Yubin-dev0/thesis-edgeai-adaptive-kalman-embedded/tests/06_kf_integration_verification/csv_extracted/phase6_step6_csv.csv

seq | timestamp_ms | enc_L | enc_R | pos_L_mm | pos_R_mm | tof_dist_mm | tof_status | tof_signal_mcps | tof_ambient_mcps | kf_estimate | kf_covariance | residual | residual_var | residual_mean | kalman_gain | innovation_cov | scenario_id
0 | 7 | 0 | 0 | 0.000 | 0.000 | 124 | 0 | 23.016 | 0.156 | 124.000 | 400.000 | 0.000 | 0.000 | 0.000 | 0.000000 | 0.000 | 0
1 | 25 | 0 | 0 | 0.000 | 0.000 | 123 | 0 | 22.211 | 0.156 | 123.499 | 200.250 | -1.000 | 0.000 | 0.000 | 0.500624 | 801.000 | 0
2 | 45 | 0 | 0 | 0.000 | 0.000 | 123 | 0 | 22.102 | 0.188 | 123.332 | 133.888 | -0.499 | 0.000 | 0.000 | 0.334719 | 601.250 | 0
3 | 65 | 0 | 0 | 0.000 | 0.000 | 122 | 0 | 22.086 | 0.164 | 122.996 | 100.872 | -1.332 | 0.000 | 0.000 | 0.252179 | 534.888 | 0
4 | 85 | 0 | 0 | 0.000 | 0.000 | 122 | 0 | 22.078 | 0.180 | 122.794 | 81.193 | -0.996 | 0.000 | 0.000 | 0.202984 | 501.872 | 0
5 | 107 | 0 | 0 | 0.000 | 0.000 | 121 | 0 | 22.180 | 0.156 | 122.705 | 58.982 | -2.000 | 0.000 | 0.000 | 0.147454 | 469.183 | 0
6 | 127 | 0 | 0 | 0.000 | 0.000 | 126 | 0 | 22.133 | 0.188 | 123.134 | 52.160 | 3.295 | 0.000 | 0.000 | 0.130400 | 459.982 | 0
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
