Yubin-dev0/thesis-edgeai-adaptive-kalman-embedded/tests/00_power_verification/logs/phase0_wiring_overview.jpg

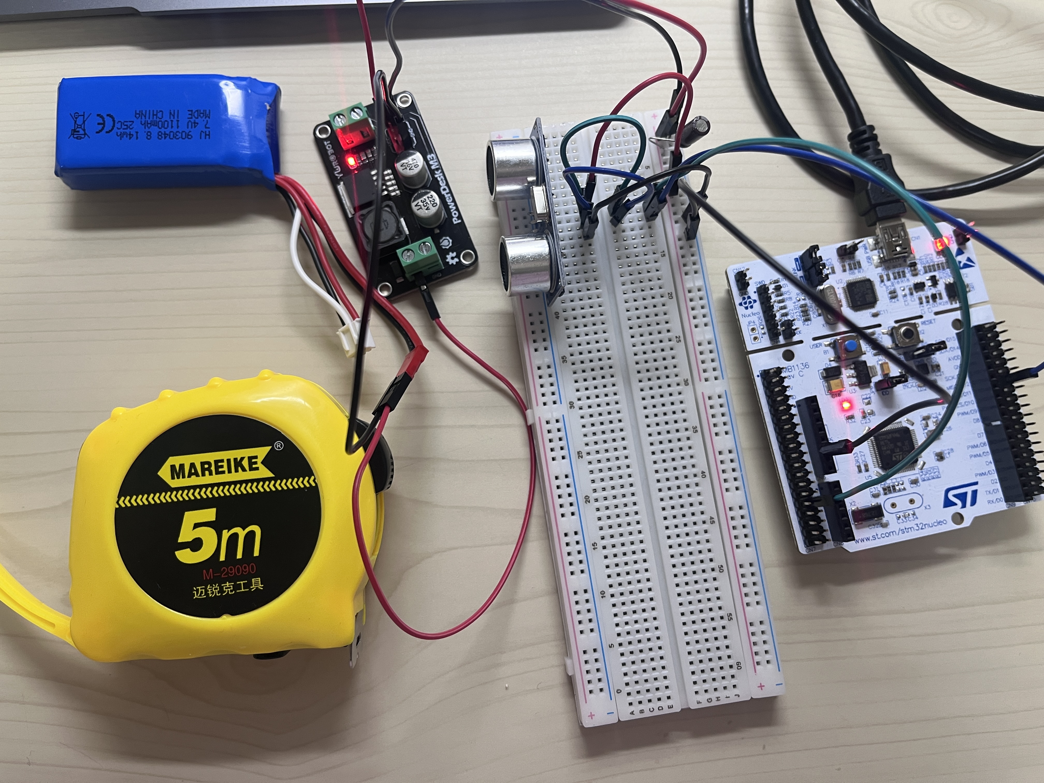
tests/00_power_verification/logs/phase0_wiring_overview.jpg
