Yubin-dev0/thesis-edgeai-adaptive-kalman-embedded/tests/04A_motor_standalone_verification/logs/motor_wiring_overview.jpg

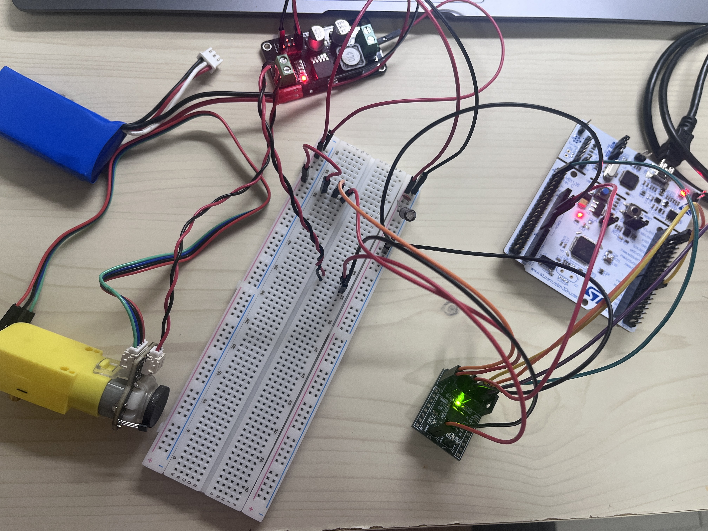
tests/04A_motor_standalone_verification/logs/motor_wiring_overview.jpg
