Yubin-dev0/thesis-edgeai-adaptive-kalman-embedded/tests/07_manual_integration_verification/wiring_overview.jpg

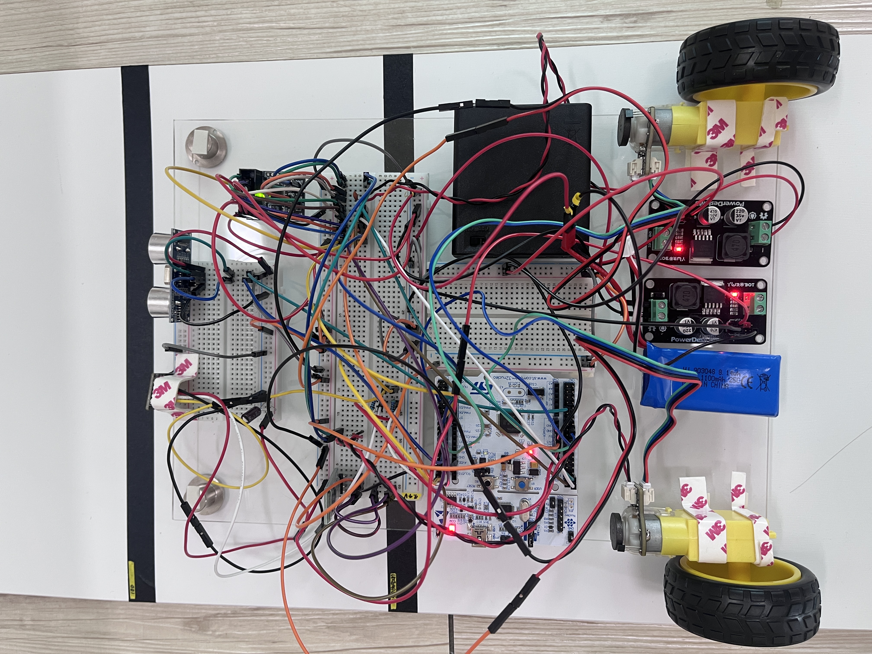
tests/07_manual_integration_verification/wiring_overview.jpg
