Yubin-dev0/thesis-edgeai-adaptive-kalman-embedded/tests/03_hcsr04_verification/TEST_RESULT.md

# Phase 3: HC-SR04 Ultrasonic Sensor Verification

## Objective
Validate HC-SR04 distance measurement using TIM3 Input Capture interrupts (no polling, no main-loop blocking).

## Hardware Setup
- **MCU**: STM32 NUCLEO-F446RE (HSE 8MHz BYPASS via ST-LINK MCO → PLL → 180MHz SYSCLK)
- **Sensor**: HC-SR04 ultrasonic ranging module
- **Power**: NUCLEO 5V (USB-powered)
- **Decoupling**: 100nF ceramic capacitor across HC-SR04 VCC–GND — *not present on the final build (verified 2026-09-22); the +5 V rail feeding HC-SR04 and VL53L0X carries one 100 µF 16 V electrolytic instead*

### Wiring
| HC-SR04 | NUCLEO Pin | Function |
|---|---|---|
| VCC | 5V | Power |
| GND | GND | Ground |
| Trig | PA1 | GPIO Output |
| Echo | PA6 | TIM3_CH1 (Input Capture, 5V tolerant) |

## Firmware Configuration
- **TIM3**: Prescaler = 89, Period = 65535 → 1 µs resolution, 65.535 ms range
- **Input Capture**: Both edges (rising → falling), Direct mode, no filter
- **Trigger**: 10 µs pulse generated with DWT cycle counter delay
- **Trigger period**: 50 ms (20 Hz)
- **Distance formula**: `d_mm = pulse_us × 0.1715` (speed of sound ÷ 2)
- **printf retarget**: USART2 @ 115200 baud (ST-LINK VCP)

## Test Results

### 3-1: Trigger + Echo Capture
| Item | Result | Pass/Fail |
|---|---|---|
| `echo_ready` flag set after each trigger | Yes, 985 consecutive captures | ✅ Pass |
| Both rising/falling edges captured | Verified via pulse width values | ✅ Pass |

### 3-2: Fixed Distance Accuracy
Reference distances using A4 paper (297 mm long edge).

| Target | Measured Mean | Error | Std Dev (σ) | Samples | Pass/Fail |
|---|---|---|---|---|---|
| 297 mm (1 sheet) | 291.3 mm | -5.7 mm | ±5.6 mm | 214 | ✅ Pass |
| 594 mm (2 sheets) | 575.3 mm | -18.7 mm | ±3.5 mm | 156 | ⚠️ Marginal |
| 891 mm (3 sheets) | 871.4 mm | -19.6 mm | ±4.9 mm | 164 | ⚠️ Marginal |

**Notes on 594 mm / 891 mm results:**
The systematic offset (~-19 mm) is consistent across both multi-sheet measurements but absent in the single-sheet test. This strongly suggests **mechanical alignment error from overlapping A4 sheets** during reference distance setup, not a sensor or firmware issue. Sensor jitter remained excellent (σ < 5 mm) at all distances, well within HC-SR04 datasheet spec (±3 mm + 1%). Re-measurement with a calibrated ruler is planned once available.

### 3-3: 20 Hz Trigger Period
| Item | Result | Pass/Fail |
|---|---|---|
| Measurement count over 50 s | 985 samples | ✅ Pass (~19.7 Hz) |
| `echo_ready` flag period | ~50 ms | ✅ Pass |

### 3-4: Non-Blocking Main Loop
| Item | Result | Pass/Fail |
|---|---|---|
| `loop_max` (DWT-measured) | 5130 µs | ✅ Pass* |
| Main loop blocked during echo wait | 0 µs (interrupt-driven) | ✅ Pass |
| `while`-loop polling on Echo pin | None (verified by code review) | ✅ Pass |

*Note: The 5.1 ms `loop_max` is dominated by `HAL_UART_Transmit` blocking during printf (~50 chars × 87 µs/char @ 115200 baud ≈ 4.3 ms). Echo wait itself contributes 0 µs since capture is fully interrupt-driven. Will be replaced with DMA-based UART output in a later phase.

## Key Learnings
1. **HSE BYPASS mode** is required on NUCLEO boards (not Crystal/Resonator) since the ST-LINK MCU supplies an 8 MHz clock signal directly.
2. **100nF decoupling cap** placed at the sensor pins eliminated VCC noise during ultrasonic burst transmission. *(Phase 3 bench observation; the cap is not on the final build — see Hardware Setup.)*
3. **TIM3 Input Capture with Both Edges polarity** allows capturing rising and falling edges on a single channel by toggling polarity in the ISR — no need for two channels.
4. **DWT cycle counter** provides sub-microsecond delay precision and zero-overhead loop timing measurement, essential for verifying non-blocking behavior.
5. **Systematic measurement offset** vs random jitter — when errors are consistent in magnitude and direction across samples, the root cause is almost always physical setup, not sensor or firmware.

## Files
- `firmware/Core/Src/main.c` — HC-SR04 driver in USER CODE sections
- `logs/putty4.log` — Final test session capture

## Status
✅ **Phase 3 Complete** — HC-SR04 functional with interrupt-driven capture. Ready to proceed to Phase 4.
