Yubin-dev0/thesis-edgeai-adaptive-kalman-embedded/experiments/E1_baseline/logs_final/E1_run01.csv

seq | timestamp_ms | tof_distance_mm | tof_signal_rate | tof_range_status | us_distance_mm | encoder_distance_mm | encoder_speed_mms | sensor_disagree | tof_meas_rate | gt_distance_mm | scenario_id | fixed_estimate_mm | fixed_residual | fixed_residual_var | fixed_residual_mean | fixed_kalman_gain | fixed_innovation_cov | cm_estimate_mm | cm_residual | cm_residual_var | cm_residual_mean | cm_kalman_gain | cm_innovation_cov | cm_R | tinyml_estimate_mm | tinyml_R | tinyml_infer_us
0 | 7 | 514 | 3.812 | 0 | 0.000 | 0.000 | 0.000 | 514.000 | 1.000 | 0.000 | 1 | 514.000 | 0.000 | 0.000 | 0.000 | 0.000000 | 0.000 | 514.000 | 0.000 | 0.000 | 0.000 | 0.000000 | 0.000 | 24.000 | 514.000 | 24.000 | 0
1 | 25 | 518 | 3.695 | 0 | 492.548 | 0.000 | 0.000 | 25.452 | 1.000 | 0.000 | 1 | 516.041 | 4.000 | 0.000 | 0.000 | 0.510204 | 49.000 | 516.041 | 4.000 | 0.000 | 0.000 | 0.510204 | 49.000 | 24.000 | 517.483 | 3.714 | 35
2 | 45 | 512 | 3.656 | 0 | 492.548 | 0.000 | 0.000 | 19.452 | 1.000 | 0.000 | 1 | 514.604 | -4.041 | 0.000 | 0.000 | 0.355616 | 37.245 | 514.604 | -4.041 | 0.000 | 0.000 | 0.355616 | 37.245 | 24.000 | 514.562 | 3.714 | 35
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
