Yubin-dev0/thesis-edgeai-adaptive-kalman-embedded/experiments/E1_baseline/logs/E1_run01.csv

seq | timestamp_ms | tof_distance_mm | tof_signal_rate | tof_range_status | us_distance_mm | encoder_distance_mm | encoder_speed_mms | sensor_disagree | tof_meas_rate | gt_distance_mm | scenario_id | fixed_estimate_mm | fixed_residual | fixed_residual_var | fixed_residual_mean | fixed_kalman_gain | fixed_innovation_cov | cm_estimate_mm | cm_residual | cm_residual_var | cm_residual_mean | cm_kalman_gain | cm_innovation_cov | cm_R
0 | 7 | 522 | 3.641 | 0 | 0.000 | 0.000 | 0.000 | 522.000 | 0.000 | 0.000 | 1 | 522.000 | 0.000 | 0.000 | 0.000 | 0.000000 | 0.000 | 522.000 | 0.000 | 0.000 | 0.000 | 0.000000 | 0.000 | 24.000
1 | 25 | 527 | 3.555 | 0 | 488.432 | 0.000 | 0.000 | 38.568 | 5.000 | 0.000 | 1 | 524.551 | 5.000 | 0.000 | 0.000 | 0.510204 | 49.000 | 524.551 | 5.000 | 0.000 | 0.000 | 0.510204 | 49.000 | 24.000
2 | 45 | 510 | 3.625 | 0 | 488.432 | 0.000 | 0.000 | 21.568 | -17.000 | 0.000 | 1 | 519.376 | -14.551 | 0.000 | 0.000 | 0.355616 | 37.245 | 519.376 | -14.551 | 0.000 | 0.000 | 0.355616 | 37.245 | 24.000
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
