Yubin-dev0/thesis-edgeai-adaptive-kalman-embedded/experiments/E1_baseline/logs/E1_run02.csv

seq | timestamp_ms | tof_distance_mm | tof_signal_rate | tof_range_status | us_distance_mm | encoder_distance_mm | encoder_speed_mms | sensor_disagree | tof_meas_rate | gt_distance_mm | scenario_id | fixed_estimate_mm | fixed_residual | fixed_residual_var | fixed_residual_mean | fixed_kalman_gain | fixed_innovation_cov | cm_estimate_mm | cm_residual | cm_residual_var | cm_residual_mean | cm_kalman_gain | cm_innovation_cov | cm_R
0 | 7 | 510 | 3.523 | 0 | 0.000 | 0.000 | 0.000 | 510.000 | 0.000 | 0.000 | 1 | 510.000 | 0.000 | 0.000 | 0.000 | 0.000000 | 0.000 | 510.000 | 0.000 | 0.000 | 0.000 | 0.000000 | 0.000 | 24.000
2 | 45 | 512 | 3.570 | 0 | 488.432 | 0.000 | 0.000 | 23.568 | -3.000 | 0.000 | 1 | 512.355 | -0.551 | 0.000 | 0.000 | 0.355616 | 37.245 | 512.355 | -0.551 | 0.000 | 0.000 | 0.355616 | 37.245 | 24.000
3 | 65 | 513 | 3.625 | 0 | 488.432 | 0.000 | 0.000 | 24.568 | 1.000 | 0.000 | 1 | 512.538 | 0.645 | 0.000 | 0.000 | 0.284325 | 33.535 | 512.538 | 0.645 | 0.000 | 0.000 | 0.284325 | 33.535 | 24.000
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
