Yubin-dev0/thesis-edgeai-adaptive-kalman-embedded/experiments/E1_baseline/logs/E1_run03.csv

seq | timestamp_ms | tof_distance_mm | tof_signal_rate | tof_range_status | us_distance_mm | encoder_distance_mm | encoder_speed_mms | sensor_disagree | tof_meas_rate | gt_distance_mm | scenario_id | fixed_estimate_mm | fixed_residual | fixed_residual_var | fixed_residual_mean | fixed_kalman_gain | fixed_innovation_cov | cm_estimate_mm | cm_residual | cm_residual_var | cm_residual_mean | cm_kalman_gain | cm_innovation_cov | cm_R
0 | 7 | 520 | 3.594 | 0 | 0.000 | 0.000 | 0.000 | 520.000 | 0.000 | 0.000 | 1 | 520.000 | 0.000 | 0.000 | 0.000 | 0.000000 | 0.000 | 520.000 | 0.000 | 0.000 | 0.000 | 0.000000 | 0.000 | 24.000
1 | 27 | 508 | 3.508 | 0 | 486.374 | 0.000 | 0.000 | 21.626 | -12.000 | 0.000 | 1 | 513.878 | -12.000 | 0.000 | 0.000 | 0.510204 | 49.000 | 513.878 | -12.000 | 0.000 | 0.000 | 0.510204 | 49.000 | 24.000
2 | 45 | 503 | 3.516 | 0 | 486.374 | 0.000 | 0.000 | 16.626 | -5.000 | 0.000 | 1 | 510.009 | -10.878 | 0.000 | 0.000 | 0.355616 | 37.245 | 510.009 | -10.878 | 0.000 | 0.000 | 0.355616 | 37.245 | 24.000
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
