Yubin-dev0/thesis-edgeai-adaptive-kalman-embedded/experiments/E1_baseline/logs/E1_run04.csv

seq | timestamp_ms | tof_distance_mm | tof_signal_rate | tof_range_status | us_distance_mm | encoder_distance_mm | encoder_speed_mms | sensor_disagree | tof_meas_rate | gt_distance_mm | scenario_id | fixed_estimate_mm | fixed_residual | fixed_residual_var | fixed_residual_mean | fixed_kalman_gain | fixed_innovation_cov | cm_estimate_mm | cm_residual | cm_residual_var | cm_residual_mean | cm_kalman_gain | cm_innovation_cov | cm_R
0 | 7 | 504 | 3.438 | 0 | 0.000 | 0.000 | 0.000 | 504.000 | 0.000 | 0.000 | 1 | 504.000 | 0.000 | 0.000 | 0.000 | 0.000000 | 0.000 | 504.000 | 0.000 | 0.000 | 0.000 | 0.000000 | 0.000 | 24.000
1 | 27 | 508 | 3.562 | 0 | 492.719 | 0.000 | 0.000 | 15.281 | 4.000 | 0.000 | 1 | 506.041 | 4.000 | 0.000 | 0.000 | 0.510204 | 49.000 | 506.041 | 4.000 | 0.000 | 0.000 | 0.510204 | 49.000 | 24.000
2 | 47 | 516 | 3.594 | 0 | 492.719 | 0.000 | 0.000 | 23.281 | 8.000 | 0.000 | 1 | 509.582 | 9.959 | 0.000 | 0.000 | 0.355616 | 37.245 | 509.582 | 9.959 | 0.000 | 0.000 | 0.355616 | 37.245 | 24.000
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
