Yubin-dev0/thesis-edgeai-adaptive-kalman-embedded/experiments/E1_baseline/logs/E1_run05.csv

seq | timestamp_ms | tof_distance_mm | tof_signal_rate | tof_range_status | us_distance_mm | encoder_distance_mm | encoder_speed_mms | sensor_disagree | tof_meas_rate | gt_distance_mm | scenario_id | fixed_estimate_mm | fixed_residual | fixed_residual_var | fixed_residual_mean | fixed_kalman_gain | fixed_innovation_cov | cm_estimate_mm | cm_residual | cm_residual_var | cm_residual_mean | cm_kalman_gain | cm_innovation_cov | cm_R
0 | 7 | 518 | 3.516 | 0 | 0.000 | 0.000 | 0.000 | 518.000 | 0.000 | 0.000 | 1 | 518.000 | 0.000 | 0.000 | 0.000 | 0.000000 | 0.000 | 518.000 | 0.000 | 0.000 | 0.000 | 0.000000 | 0.000 | 24.000
1 | 25 | 512 | 3.500 | 0 | 486.717 | 0.000 | 0.000 | 25.283 | -6.000 | 0.000 | 1 | 514.939 | -6.000 | 0.000 | 0.000 | 0.510204 | 49.000 | 514.939 | -6.000 | 0.000 | 0.000 | 0.510204 | 49.000 | 24.000
2 | 45 | 508 | 3.594 | 0 | 486.717 | 0.000 | 0.000 | 21.283 | -4.000 | 0.000 | 1 | 512.471 | -6.939 | 0.000 | 0.000 | 0.355616 | 37.245 | 512.471 | -6.939 | 0.000 | 0.000 | 0.355616 | 37.245 | 24.000
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
