Yubin-dev0/thesis-edgeai-adaptive-kalman-embedded/firmware/Core/Src/network.c

/**
  ******************************************************************************
  * @file    network.c
  * @author  AST Embedded Analytics Research Platform
  * @date    2026-05-20T19:15:52+0900
  * @brief   AI Tool Automatic Code Generator for Embedded NN computing
  ******************************************************************************
  * @attention
  *
  * Copyright (c) 2026 STMicroelectronics.
  * All rights reserved.
  *
  * This software is licensed under terms that can be found in the LICENSE file
  * in the root directory of this software component.
  * If no LICENSE file comes with this software, it is provided AS-IS.
  ******************************************************************************
  */

#include "ai_lite_inspect.h"
#include "ai_platform_interface.h"
#include "layers.h"
#include "core_convert.h"
#include "network.h"
#include "network_details.h"
#include "network_data.h"
#include "stai_events.h"

#include "ai_lite_inspect.h"

#include "lite_operators.h"
/*****************************************************************************/
#define STAI_INTERNAL_API_MAJOR               (1)
#define STAI_INTERNAL_API_MINOR               (0)
#define STAI_INTERNAL_API_MICRO               (0)

#define STAI_MAGIC                            (0xB1C00100)

/*****************************************************************************/
#define _STAI_CONCAT_ARG(a, b)     a ## b
#define STAI_CONCAT(a, b)         _STAI_CONCAT_ARG(a, b)

/*!  STAI_CAST SECTION                       *********************************/
#define STAI_CAST(type, expr) \
  ((type)(expr))


/*****************************************************************************/
#define STAI_SIZE(_size) \
  ((stai_size)(_size))

/*****************************************************************************/
#define STAI_INIT_BUFFER(_flags, _size, _address) \
  { \
    .size = (_size), \
    .address = (uintptr_t)(_address), \
    .flags = (_flags), \
  }

#define STAI_INIT_TENSOR(_name, _flags, _fmt, _size_bytes, _shape, _scale, _zeropoint) \
  { \
    .size_bytes = (_size_bytes), \
    .flags = (_flags), \
    .format = (stai_format)(_fmt), \
    .shape = STAI_PACK(_shape), \
    .scale = STAI_PACK(_scale), \
    .zeropoint = STAI_PACK(_zeropoint), \
    .name = (_name) \
  }

#define STAI_INIT_ARRAY(_size, _ptr) \
  { .size = STAI_SIZE(_size), .data = STAI_PACK(_ptr) }


#define STAI_CAST_ARRAY(_type, _size, _ptr) \
  { .size = STAI_SIZE(_size), .data = (_type)STAI_PACK(_ptr) }


#define STAI_DECLARE_ARRAY(_type, _size, ...) \
  { .size = STAI_SIZE(_size), .data = (_type[_size]) { STAI_PACK(__VA_ARGS__) } }


#define STAI_EMPTY_ARRAY() \
  { .size = 0, .data = NULL }


#define STAI_INIT_VERSION(_major, _minor, _micro) \
  { .major = (_major), .minor = (_minor), .micro = (_micro), .reserved = 0x0 }

/*****************************************************************************/
/**  Getters and setters  **/

#define STAI_GET_ARRAY_SIZE(nd_array) \
  (nd_array.size)


#define STAI_GET_ARRAY_ELEM(nd_array, pos) \
  (nd_array.data[(pos)])

#define _STAI_SET_ERROR(net_ctx, cond, value, exit) { \
  if (!(net_ctx)) { return STAI_ERROR_NETWORK_INVALID_CONTEXT_HANDLE; } \
  if (((uintptr_t)net_ctx) & (_STAI_CONTEXT_ALIGNMENT-1)) { return STAI_ERROR_NETWORK_INVALID_CONTEXT_ALIGNMENT; } \
  if (((value) >= STAI_ERROR_GENERIC) && (cond)) { \
    if ((net_ctx)->_return_code == STAI_SUCCESS) { \
      (net_ctx)->_return_code = (value); \
    } \
    return (exit); \
  } \
}

/*****************************************************************************/
/* TODO REMOVE THESE TWO MACROS */
#define STAI_EVENT_NODE_START_CB
#define STAI_EVENT_NODE_STOP_CB

#ifdef STAI_EVENT_NODE_START_CB
#ifndef _STAI_NETWORK_EVENT_NODE_START_CB
  #define _STAI_NETWORK_EVENT_NODE_START_CB(_node_id, _buffers_size, ...) \
  if (net_ctx->_callback) { \
    const stai_event_node_start_stop _start_event = { \
      .node_id=(_node_id), \
      .buffers={ \
        .size=(_buffers_size), \
        .data=(stai_ptr const*)(const stai_ptr[_buffers_size])STAI_PACK(__VA_ARGS__) \
      } \
    }; \
    net_ctx->_callback(net_ctx->_callback_cookie, STAI_EVENT_NODE_START, (const void*)&_start_event); \
  }
#endif
#else
  #define _STAI_NETWORK_EVENT_NODE_START_CB(_node_id, _buffers_size, ...) \
    do { /* _STAI_NETWORK_EVENT_NODE_START_CB() */ } while(0);
#endif      /* STAI_EVENT_NODE_START_CB */

#ifdef STAI_EVENT_NODE_STOP_CB
#ifndef _STAI_NETWORK_EVENT_NODE_STOP_CB
  #define _STAI_NETWORK_EVENT_NODE_STOP_CB(_node_id, _buffers_size, ...) \
  if (net_ctx->_callback) { \
    const stai_event_node_start_stop _stop_event = { \
      .node_id=(_node_id), \
      .buffers={ \
        .size=(_buffers_size), \
        .data=(stai_ptr const*)(stai_ptr[_buffers_size])STAI_PACK(__VA_ARGS__) \
      } \
    }; \
    net_ctx->_callback(net_ctx->_callback_cookie, STAI_EVENT_NODE_STOP, (const void*)&_stop_event); \
  }
#endif
#else
  #define _STAI_NETWORK_EVENT_NODE_STOP_CB(_node_id, _buffers_size, ...) \
    do { /* _STAI_NETWORK_EVENT_NODE_STOP_CB() */ } while(0);
#endif      /* STAI_EVENT_NODE_STOP_CB */


/*****************************************************************************/
#define _STAI_NETWORK_MODEL_SIGNATURE     "0x8c37d5fbafeb3c064021bda618ba8f09"
#define _STAI_NETWORK_DATETIME            "2026-05-20T19:15:52+0900"
#define _STAI_NETWORK_COMPILE_DATETIME    __DATE__ " " __TIME__

#define _STAI_CONTEXT_ALIGNMENT        STAI_NETWORK_CONTEXT_ALIGNMENT

/*****************************************************************************/
#define g_network_activations_1     (NULL)




#if defined(HAVE_NETWORK_INFO)
/*****************************************************************************/
static const stai_network_info g_network_info = {
  .model_signature = _STAI_NETWORK_MODEL_SIGNATURE,
  .c_compile_datetime = _STAI_NETWORK_COMPILE_DATETIME,
  .c_model_name = STAI_NETWORK_MODEL_NAME,
  .c_model_datetime = _STAI_NETWORK_DATETIME,
  .c_model_signature = 0x0,
  .runtime_version = STAI_INIT_VERSION(12, 0, 0),
  .tool_version = STAI_INIT_VERSION(4, 0, 0),
  .api_version = STAI_INIT_VERSION(1, 0, 0),
  .n_macc = STAI_NETWORK_MACC_NUM,
  .n_nodes = STAI_NETWORK_NODES_NUM,
  .flags = STAI_NETWORK_FLAGS,
  .n_inputs = STAI_NETWORK_IN_NUM,
  .n_outputs = STAI_NETWORK_OUT_NUM,
  .n_activations = STAI_NETWORK_ACTIVATIONS_NUM,
  .n_weights = STAI_NETWORK_WEIGHTS_NUM,
  .n_states = STAI_NETWORK_STATES_NUM,
  .inputs = (stai_tensor[STAI_NETWORK_IN_NUM]) {
    STAI_INIT_TENSOR(
      STAI_NETWORK_IN_1_NAME,
      STAI_NETWORK_IN_1_FLAGS,
      STAI_NETWORK_IN_1_FORMAT,
      STAI_NETWORK_IN_1_SIZE_BYTES,
      STAI_DECLARE_ARRAY(int32_t, 2, 1, 6),
      STAI_DECLARE_ARRAY(float, 1, 0.9137470722198486f),
      STAI_DECLARE_ARRAY(int16_t, 1, 31)),
    },
    .outputs = (stai_tensor[STAI_NETWORK_OUT_NUM]) {
    STAI_INIT_TENSOR(
      STAI_NETWORK_OUT_1_NAME,
      STAI_NETWORK_OUT_1_FLAGS,
      STAI_NETWORK_OUT_1_FORMAT,
      STAI_NETWORK_OUT_1_SIZE_BYTES,
      STAI_DECLARE_ARRAY(int32_t, 2, 1, 1),
      STAI_DECLARE_ARRAY(float, 1, 0.03876088559627533f),
      STAI_DECLARE_ARRAY(int16_t, 1, -128)),
    },
  .activations = (stai_tensor[STAI_NETWORK_ACTIVATIONS_NUM]) {
    STAI_INIT_TENSOR(
      (NULL),
      STAI_NETWORK_ACTIVATION_1_FLAGS,
      STAI_FORMAT_U8,
      STAI_NETWORK_ACTIVATION_1_SIZE_BYTES,
      STAI_DECLARE_ARRAY(int32_t, 1, 196),
      STAI_EMPTY_ARRAY(),
      STAI_EMPTY_ARRAY()),
    },
  .weights = (stai_tensor[STAI_NETWORK_WEIGHTS_NUM]) {
    STAI_INIT_TENSOR(
      (NULL),
      STAI_NETWORK_WEIGHT_1_FLAGS,
      STAI_FORMAT_U8,
      STAI_NETWORK_WEIGHT_1_SIZE_BYTES,
      STAI_DECLARE_ARRAY(int32_t, 1, 332),
      STAI_EMPTY_ARRAY(),
      STAI_EMPTY_ARRAY()),
    },

  .states = NULL
};
#endif

#define _STAI_CONTEXT_ACQUIRE(_net_ctx, _net_handle) \
  _stai_network_context* _net_ctx = (_stai_network_context*)(_net_handle); \
  STAI_ASSERT(_net_ctx != NULL) \
  _STAI_SET_ERROR(_net_ctx, _net_ctx->_magic != STAI_MAGIC, \
                  STAI_ERROR_NETWORK_INVALID_CONTEXT_HANDLE, _net_ctx->_return_code)


/*****************************************************************************/
static
void _stai_network_check(_stai_network_context* net_ctx)
{
  stai_size idx;

// Check activations status
  for (idx=0; idx<STAI_NETWORK_ACTIVATIONS_NUM; idx++) {
    if (net_ctx->_activations[idx] == NULL) break;
  }
  net_ctx->_flags |= (idx == STAI_NETWORK_ACTIVATIONS_NUM) ? STAI_FLAG_ACTIVATIONS : STAI_FLAG_NONE;
// Check inputs status
  for (idx=0; idx<STAI_NETWORK_IN_NUM; idx++) {
    if (net_ctx->_inputs[idx] == NULL) break;
  }
  net_ctx->_flags |= (idx == STAI_NETWORK_IN_NUM) ? STAI_FLAG_INPUTS : STAI_FLAG_NONE;

  // Check outputs status
  for (idx=0; idx<STAI_NETWORK_OUT_NUM; idx++) {
    if (net_ctx->_outputs[idx] == NULL) break;
  }
  net_ctx->_flags |= (idx == STAI_NETWORK_OUT_NUM) ? STAI_FLAG_OUTPUTS : STAI_FLAG_NONE;

// Check weights status
  for (idx=0; idx<STAI_NETWORK_WEIGHTS_NUM; idx++) {
    if (net_ctx->_weights[idx] == NULL) break;
  }
  net_ctx->_flags |= (idx == STAI_NETWORK_WEIGHTS_NUM) ? STAI_FLAG_WEIGHTS : STAI_FLAG_NONE;
STAI_PRINT("  [_stai_network_check] flags: 0x%08x\n", net_ctx->_flags)
}


/*****************************************************************************/
STAI_API_ENTRY
stai_return_code stai_network_init(
  stai_network* network)
{
  /* Memory where to store internal context is provided by applications as a raw byte buffer */
  _stai_network_context* net_ctx = (_stai_network_context*)(network);
  net_ctx->_return_code = STAI_SUCCESS;
  STAI_PRINT("[Entering Network Init] network(%p) context_size(%d)\n", net_ctx, (int32_t)sizeof(_stai_network_context))

  _STAI_SET_ERROR(net_ctx, STAI_NETWORK_CONTEXT_SIZE != sizeof(_stai_network_context),
                 STAI_ERROR_NETWORK_INVALID_CONTEXT_SIZE, net_ctx->_return_code)

  {
    const _stai_network_context _network_context = {
      ._magic = STAI_MAGIC,
      ._signature = STAI_NETWORK_MODEL_SIGNATURE,
      ._flags = STAI_NETWORK_FLAGS,
      ._return_code = STAI_SUCCESS,
      ._callback = NULL,
      ._callback_cookie = NULL,
      ._activations = {
      (stai_ptr)g_network_activations_1
      },
      ._weights = {
      (stai_ptr)g_network_weights_array
      },
      ._inputs = {
    NULL},
      ._outputs = {
    NULL},
    };

    // Deep copy of internal context to opaque buffer provided by app
    *net_ctx = _network_context;

    _stai_network_check(net_ctx);
  }

  return net_ctx->_return_code;
}


STAI_API_ENTRY
stai_return_code stai_network_deinit(
  stai_network* network)
{
  _STAI_CONTEXT_ACQUIRE(net_ctx, network)

  /*  Reset flags to initial state  */
  net_ctx->_flags = STAI_NETWORK_FLAGS;
  return net_ctx->_return_code;
}

/*****************************************************************************/



/* Int quant #0 */
AI_INTQ_INFO_LIST_OBJ_DECLARE(serving_default_features0_output_array_intq, AI_STATIC,
  AI_BUFFER_META_FLAG_SCALE_FLOAT|AI_BUFFER_META_FLAG_ZEROPOINT_S8, 1,
  AI_PACK_INTQ_INFO(
    AI_PACK_INTQ_SCALE(0.9137470722198486f),
    AI_PACK_INTQ_ZP(31)))

/* Int quant #1 */
AI_INTQ_INFO_LIST_OBJ_DECLARE(gemm_0_output_array_intq, AI_STATIC,
  AI_BUFFER_META_FLAG_SCALE_FLOAT|AI_BUFFER_META_FLAG_ZEROPOINT_S8, 1,
  AI_PACK_INTQ_INFO(
    AI_PACK_INTQ_SCALE(0.13485567271709442f),
    AI_PACK_INTQ_ZP(-128)))

/* Int quant #2 */
AI_INTQ_INFO_LIST_OBJ_DECLARE(gemm_0_weights_array_intq, AI_STATIC,
  AI_BUFFER_META_FLAG_SCALE_FLOAT|AI_BUFFER_META_FLAG_ZEROPOINT_S8, 16,
  AI_PACK_INTQ_INFO(
    AI_PACK_INTQ_SCALE(0.007842641323804855f, 0.0035275882109999657f, 0.004507462028414011f, 0.003954972606152296f, 0.0035938553046435118f, 0.0027614738792181015f, 0.007583349011838436f, 0.004742293618619442f, 0.009044609032571316f, 0.006697522010654211f, 0.006466713268309832f, 0.003373105311766267f, 0.004644690081477165f, 0.007187842391431332f, 0.01097428984940052f, 0.0037456275895237923f),
    AI_PACK_INTQ_ZP(0, 0, 0, 0, 0, 0, 0, 0, 0, 0, 0, 0, 0, 0, 0, 0)))

/* Int quant #3 */
AI_INTQ_INFO_LIST_OBJ_DECLARE(gemm_1_output_array_intq, AI_STATIC,
  AI_BUFFER_META_FLAG_SCALE_FLOAT|AI_BUFFER_META_FLAG_ZEROPOINT_S8, 1,
  AI_PACK_INTQ_INFO(
    AI_PACK_INTQ_SCALE(0.1094886064529419f),
    AI_PACK_INTQ_ZP(-128)))

/* Int quant #4 */
AI_INTQ_INFO_LIST_OBJ_DECLARE(gemm_1_weights_array_intq, AI_STATIC,
  AI_BUFFER_META_FLAG_SCALE_FLOAT|AI_BUFFER_META_FLAG_ZEROPOINT_S8, 8,
  AI_PACK_INTQ_INFO(
    AI_PACK_INTQ_SCALE(0.004011020064353943f, 0.008533353917300701f, 0.004245095886290073f, 0.009418073110282421f, 0.00605045584961772f, 0.00622981134802103f, 0.004354054573923349f, 0.004858034662902355f),
    AI_PACK_INTQ_ZP(0, 0, 0, 0, 0, 0, 0, 0)))



/* Array#0 */
AI_ARRAY_OBJ_DECLARE(
  serving_default_features0_output_array, AI_ARRAY_FORMAT_S8|AI_FMT_FLAG_IS_IO,
  NULL, NULL, 6, AI_STATIC)

/* Array#1 */
AI_ARRAY_OBJ_DECLARE(
  gemm_0_output_array, AI_ARRAY_FORMAT_S8,
  NULL, NULL, 16, AI_STATIC)

/* Array#2 */
AI_ARRAY_OBJ_DECLARE(
  gemm_0_weights_array, AI_ARRAY_FORMAT_S8,
  NULL, NULL, 96, AI_STATIC)

/* Array#3 */
AI_ARRAY_OBJ_DECLARE(
  gemm_0_bias_array, AI_ARRAY_FORMAT_S32,
  NULL, NULL, 16, AI_STATIC)

/* Array#4 */
AI_ARRAY_OBJ_DECLARE(
  gemm_0_scratch0_array, AI_ARRAY_FORMAT_S16,
  NULL, NULL, 86, AI_STATIC)

/* Array#5 */
AI_ARRAY_OBJ_DECLARE(
  gemm_1_output_array, AI_ARRAY_FORMAT_S8,
  NULL, NULL, 8, AI_STATIC)

/* Array#6 */
AI_ARRAY_OBJ_DECLARE(
  gemm_1_weights_array, AI_ARRAY_FORMAT_S8,
  NULL, NULL, 128, AI_STATIC)

/* Array#7 */
AI_ARRAY_OBJ_DECLARE(
  gemm_1_bias_array, AI_ARRAY_FORMAT_S32,
  NULL, NULL, 8, AI_STATIC)

/* Array#8 */
AI_ARRAY_OBJ_DECLARE(
  gemm_1_scratch0_array, AI_ARRAY_FORMAT_S16,
  NULL, NULL, 56, AI_STATIC)



/* Tensor #0 */
AI_TENSOR_OBJ_DECLARE(
  gemm_0_bias, AI_STATIC,
  0, 0x0,
  AI_SHAPE_INIT(4, 1, 16, 1, 1), AI_STRIDE_INIT(4, 4, 4, 64, 64),
  1, &gemm_0_bias_array, NULL)

/* Tensor #1 */
AI_TENSOR_OBJ_DECLARE(
  gemm_0_output, AI_STATIC,
  1, 0x1,
  AI_SHAPE_INIT(4, 1, 16, 1, 1), AI_STRIDE_INIT(4, 1, 1, 16, 16),
  1, &gemm_0_output_array, &gemm_0_output_array_intq)

/* Tensor #2 */
AI_TENSOR_OBJ_DECLARE(
  gemm_0_scratch0, AI_STATIC,
  2, 0x0,
  AI_SHAPE_INIT(4, 1, 86, 1, 1), AI_STRIDE_INIT(4, 2, 2, 172, 172),
  1, &gemm_0_scratch0_array, NULL)

/* Tensor #3 */
AI_TENSOR_OBJ_DECLARE(
  gemm_0_weights, AI_STATIC,
  3, 0x1,
  AI_SHAPE_INIT(4, 6, 16, 1, 1), AI_STRIDE_INIT(4, 1, 6, 96, 96),
  1, &gemm_0_weights_array, &gemm_0_weights_array_intq)

/* Tensor #4 */
AI_TENSOR_OBJ_DECLARE(
  serving_default_features0_output, AI_STATIC,
  12, 0x1,
  AI_SHAPE_INIT(4, 1, 6, 1, 1), AI_STRIDE_INIT(4, 1, 1, 6, 6),
  1, &serving_default_features0_output_array, &serving_default_features0_output_array_intq)

/* Tensor #5 */
AI_TENSOR_OBJ_DECLARE(
  gemm_1_bias, AI_STATIC,
  4, 0x0,
  AI_SHAPE_INIT(4, 1, 8, 1, 1), AI_STRIDE_INIT(4, 4, 4, 32, 32),
  1, &gemm_1_bias_array, NULL)

/* Tensor #6 */
AI_TENSOR_OBJ_DECLARE(
  gemm_1_output, AI_STATIC,
  5, 0x1,
  AI_SHAPE_INIT(4, 1, 8, 1, 1), AI_STRIDE_INIT(4, 1, 1, 8, 8),
  1, &gemm_1_output_array, &gemm_1_output_array_intq)

/* Tensor #7 */
AI_TENSOR_OBJ_DECLARE(
  gemm_1_scratch0, AI_STATIC,
  6, 0x0,
  AI_SHAPE_INIT(4, 1, 56, 1, 1), AI_STRIDE_INIT(4, 2, 2, 112, 112),
  1, &gemm_1_scratch0_array, NULL)

/* Tensor #8 */
AI_TENSOR_OBJ_DECLARE(
  gemm_1_weights, AI_STATIC,
  7, 0x1,
  AI_SHAPE_INIT(4, 16, 8, 1, 1), AI_STRIDE_INIT(4, 1, 16, 128, 128),
  1, &gemm_1_weights_array, &gemm_1_weights_array_intq)


AI_TENSOR_CHAIN_OBJ_DECLARE(
  gemm_0_chain, AI_STATIC_CONST, 4,
  AI_TENSOR_LIST_OBJ_INIT(AI_FLAG_NONE, 1, &serving_default_features0_output),
  AI_TENSOR_LIST_OBJ_INIT(AI_FLAG_NONE, 1, &gemm_0_output),
  AI_TENSOR_LIST_OBJ_INIT(AI_FLAG_NONE, 2, &gemm_0_weights, &gemm_0_bias),
  AI_TENSOR_LIST_OBJ_INIT(AI_FLAG_NONE, 1, &gemm_0_scratch0)
)

AI_LAYER_OBJ_DECLARE(
  gemm_0_layer, 0,
  DENSE_TYPE, 0x0, NULL,
  dense, forward_dense_integer_SSSA_ch,
  &gemm_0_chain,
  NULL, &gemm_0_layer, AI_STATIC, 
)

AI_TENSOR_CHAIN_OBJ_DECLARE(
  gemm_1_chain, AI_STATIC_CONST, 4,
  AI_TENSOR_LIST_OBJ_INIT(AI_FLAG_NONE, 1, &gemm_0_output),
  AI_TENSOR_LIST_OBJ_INIT(AI_FLAG_NONE, 1, &gemm_1_output),
  AI_TENSOR_LIST_OBJ_INIT(AI_FLAG_NONE, 2, &gemm_1_weights, &gemm_1_bias),
  AI_TENSOR_LIST_OBJ_INIT(AI_FLAG_NONE, 1, &gemm_1_scratch0)
)

AI_LAYER_OBJ_DECLARE(
  gemm_1_layer, 1,
  DENSE_TYPE, 0x0, NULL,
  dense, forward_dense_integer_SSSA_ch,
  &gemm_1_chain,
  NULL, &gemm_1_layer, AI_STATIC, 
)
/**  Hybrid layers declarations section  *************************************/
void forward_lite_dense_integer_SSSA_ch_gemm_0(_stai_network_context* net_ctx)
{
  serving_default_features0_output_array.data = AI_PTR(net_ctx->_inputs[0] + 0);
  serving_default_features0_output_array.data_start = AI_PTR(net_ctx->_inputs[0] + 0);
  gemm_0_weights_array.data = AI_PTR(net_ctx->_weights[0] + 0);
  gemm_0_weights_array.data_start = AI_PTR(net_ctx->_weights[0] + 0);
  gemm_0_bias_array.data = AI_PTR(net_ctx->_weights[0] + 96);
  gemm_0_bias_array.data_start = AI_PTR(net_ctx->_weights[0] + 96);
  gemm_0_scratch0_array.data = AI_PTR(net_ctx->_activations[0] + 16);
  gemm_0_scratch0_array.data_start = AI_PTR(net_ctx->_activations[0] + 16);
  gemm_0_output_array.data = AI_PTR(net_ctx->_activations[0] + 0);
  gemm_0_output_array.data_start = AI_PTR(net_ctx->_activations[0] + 0);
  _STAI_NETWORK_EVENT_NODE_START_CB(0, 1, { serving_default_features0_output.data->data});
  forward_dense_integer_SSSA_ch(&gemm_0_layer);
  _STAI_NETWORK_EVENT_NODE_STOP_CB(0, 1, { gemm_0_output.data->data});
}
void forward_lite_dense_integer_SSSA_ch_gemm_1(_stai_network_context* net_ctx)
{
  gemm_0_output_array.data = AI_PTR(net_ctx->_activations[0] + 0);
  gemm_0_output_array.data_start = AI_PTR(net_ctx->_activations[0] + 0);
  gemm_1_weights_array.data = AI_PTR(net_ctx->_weights[0] + 160);
  gemm_1_weights_array.data_start = AI_PTR(net_ctx->_weights[0] + 160);
  gemm_1_bias_array.data = AI_PTR(net_ctx->_weights[0] + 288);
  gemm_1_bias_array.data_start = AI_PTR(net_ctx->_weights[0] + 288);
  gemm_1_scratch0_array.data = AI_PTR(net_ctx->_activations[0] + 16);
  gemm_1_scratch0_array.data_start = AI_PTR(net_ctx->_activations[0] + 16);
  gemm_1_output_array.data = AI_PTR(net_ctx->_activations[0] + 128);
  gemm_1_output_array.data_start = AI_PTR(net_ctx->_activations[0] + 128);
  _STAI_NETWORK_EVENT_NODE_START_CB(1, 1, { gemm_0_output.data->data});
  forward_dense_integer_SSSA_ch(&gemm_1_layer);
  _STAI_NETWORK_EVENT_NODE_STOP_CB(1, 1, { gemm_1_output.data->data});
}

/*****************************************************************************/




static const ai_i8 gemm_2_t_in_0_fmt_zero_const_s8 = -128;
static const ai_i8 gemm_2_t_out_0_fmt_zero_const_s8 = -128;
static const ai_u16 gemm_2_t_in_0_shape_ch_const_u16 = 8;
static const ai_u16 gemm_2_t_out_0_shape_ch_const_u16 = 1;
static const ai_u32 gemm_2_t_out_0_shape_h_w_prod_const_u32 = 1;
static const ai_float gemm_2_t_in_0_fmt_scale_const_f32 = 0.1094886064529419f;
static const ai_float gemm_2_t_out_0_fmt_scale_const_f32 = 0.03876088559627533f;
static const ai_float gemm_2_t_weight_0_fmt_scale_const_f32 = 0.004470879677683115f;
STAI_API_ENTRY
stai_return_code stai_network_run(
  stai_network* network,
  const stai_run_mode mode)
{
   STAI_UNUSED(mode)
  _STAI_CONTEXT_ACQUIRE(net_ctx, network)

  _STAI_SET_ERROR(net_ctx, (net_ctx->_flags & STAI_FLAG_ACTIVATIONS) != STAI_FLAG_ACTIVATIONS,
        STAI_ERROR_NETWORK_INVALID_ACTIVATIONS_PTR, net_ctx->_return_code)

  _STAI_SET_ERROR(net_ctx, (net_ctx->_flags & STAI_FLAG_INPUTS) != STAI_FLAG_INPUTS,
                  STAI_ERROR_NETWORK_INVALID_IN_PTR, net_ctx->_return_code)
  _STAI_SET_ERROR(net_ctx, (net_ctx->_flags & STAI_FLAG_OUTPUTS) != STAI_FLAG_OUTPUTS,
                  STAI_ERROR_NETWORK_INVALID_OUT_PTR, net_ctx->_return_code)

  _STAI_SET_ERROR(net_ctx, (net_ctx->_flags & STAI_FLAG_WEIGHTS) != STAI_FLAG_WEIGHTS,
                  STAI_ERROR_NETWORK_INVALID_WEIGHTS_PTR, net_ctx->_return_code)


  /* LITE_KERNEL_SECTION BEGIN gemm_0 */
  {
    
  forward_lite_dense_integer_SSSA_ch_gemm_0(net_ctx);
  }
  /* LITE_KERNEL_SECTION END gemm_0 */
  /* LITE_KERNEL_SECTION BEGIN gemm_1 */
  {
    
  forward_lite_dense_integer_SSSA_ch_gemm_1(net_ctx);
  }
  /* LITE_KERNEL_SECTION END gemm_1 */
  /* LITE_KERNEL_SECTION BEGIN gemm_2 */
  {
      ai_i8* gemm_2_t_out_0_ptr_s8 = (ai_i8*)(net_ctx->_outputs[0] + 0);
    const ai_i8* gemm_2_t_in_0_ptr_const_s8 = (ai_i8*)(net_ctx->_activations[0] + 128);
    const ai_i8* gemm_2_t_weight_0_ptr_const_s8 = (ai_i8*)(net_ctx->_weights[0] + 320);
    const ai_i32* gemm_2_t_weight_1_ptr_const_s32 = (ai_i32*)(net_ctx->_weights[0] + 328);
    ai_i16* gemm_2_t_scratch_0_ptr_s16 = (ai_i16*)(net_ctx->_activations[0] + 0);
  
  _STAI_NETWORK_EVENT_NODE_START_CB(2, 1, {(stai_ptr) gemm_2_t_in_0_ptr_const_s8});
    
  forward_lite_dense_is8os8ws8(gemm_2_t_out_0_ptr_s8, gemm_2_t_in_0_ptr_const_s8, gemm_2_t_weight_0_ptr_const_s8, gemm_2_t_weight_1_ptr_const_s32, gemm_2_t_in_0_fmt_zero_const_s8, gemm_2_t_out_0_fmt_zero_const_s8, gemm_2_t_in_0_shape_ch_const_u16, gemm_2_t_out_0_shape_ch_const_u16, gemm_2_t_out_0_shape_h_w_prod_const_u32, gemm_2_t_in_0_fmt_scale_const_f32, gemm_2_t_out_0_fmt_scale_const_f32, gemm_2_t_weight_0_fmt_scale_const_f32, gemm_2_t_scratch_0_ptr_s16);
    
  _STAI_NETWORK_EVENT_NODE_STOP_CB(2, 1, {(stai_ptr) gemm_2_t_out_0_ptr_s8});
  }
  /* LITE_KERNEL_SECTION END gemm_2 */
  return net_ctx->_return_code;
}

/*****************************************************************************/
/*  Getters APIs Section  */
STAI_API_ENTRY
stai_size stai_network_get_context_size()
{
  return (stai_size)STAI_NETWORK_CONTEXT_SIZE;
}

#if defined(HAVE_NETWORK_INFO)
STAI_API_ENTRY
stai_return_code stai_network_get_info(
  stai_network* network,
  stai_network_info* info)
{
  _STAI_CONTEXT_ACQUIRE(net_ctx, network)
  _STAI_SET_ERROR(net_ctx, info==NULL, STAI_ERROR_NETWORK_INVALID_INFO, net_ctx->_return_code)

  // Copy of network info struct
  *info = g_network_info;

  return STAI_SUCCESS;
}
#endif


STAI_API_ENTRY
stai_return_code stai_network_get_activations(
  stai_network* network, stai_ptr* activations, stai_size* n_activations)
{
  _STAI_CONTEXT_ACQUIRE(net_ctx, network)

  _STAI_SET_ERROR(net_ctx, !n_activations, STAI_ERROR_NETWORK_INVALID_API_ARGUMENTS, net_ctx->_return_code)
  *n_activations = STAI_NETWORK_ACTIVATIONS_NUM;
for (stai_size idx=0; activations && (idx<STAI_NETWORK_ACTIVATIONS_NUM); idx++) {
    // get address of the activations buffers
    activations[idx] = net_ctx->_activations[idx];
  }return net_ctx->_return_code;
}


STAI_API_ENTRY
stai_return_code stai_network_get_weights(
  stai_network* network, stai_ptr* weights, stai_size* n_weights)
{
  _STAI_CONTEXT_ACQUIRE(net_ctx, network)
  _STAI_SET_ERROR(net_ctx, !n_weights, STAI_ERROR_NETWORK_INVALID_API_ARGUMENTS, net_ctx->_return_code)
  *n_weights = STAI_NETWORK_WEIGHTS_NUM;
for (stai_size idx=0; weights && (idx<STAI_NETWORK_WEIGHTS_NUM); idx++) {
    // get address of the weights buffers
    weights[idx] = net_ctx->_weights[idx];
  }return net_ctx->_return_code;
}


STAI_API_ENTRY
stai_return_code stai_network_get_inputs(
  stai_network* network, stai_ptr* inputs, stai_size* n_inputs)
{
  _STAI_CONTEXT_ACQUIRE(net_ctx, network)
  _STAI_SET_ERROR(net_ctx, !n_inputs, STAI_ERROR_NETWORK_INVALID_API_ARGUMENTS, net_ctx->_return_code)
  *n_inputs = STAI_NETWORK_IN_NUM;
  for (stai_size idx=0; inputs && (idx<STAI_NETWORK_IN_NUM); idx++) {
    inputs[idx] = net_ctx->_inputs[idx];
  }
  return net_ctx->_return_code;
}


STAI_API_ENTRY
stai_return_code stai_network_get_outputs(
  stai_network* network, stai_ptr* outputs, stai_size* n_outputs)
{
  _STAI_CONTEXT_ACQUIRE(net_ctx, network)
  _STAI_SET_ERROR(net_ctx, !n_outputs, STAI_ERROR_NETWORK_INVALID_API_ARGUMENTS, net_ctx->_return_code)
  *n_outputs = STAI_NETWORK_OUT_NUM;
  for (stai_size idx=0; outputs && (idx<STAI_NETWORK_OUT_NUM); idx++) {
    outputs[idx] = net_ctx->_outputs[idx];
  }
  return net_ctx->_return_code;
}


STAI_API_ENTRY
stai_return_code stai_network_get_error(
  stai_network* network)
{
  _STAI_CONTEXT_ACQUIRE(net_ctx, network)

  /* return 1st generated error or STAI_SUCCESS if no errors so far */
  return net_ctx->_return_code;
}


STAI_API_ENTRY
stai_return_code stai_network_get_states(
  stai_network* network, stai_ptr* states, stai_size* n_states)
{
  _STAI_CONTEXT_ACQUIRE(net_ctx, network)
  _STAI_SET_ERROR(net_ctx, !n_states, STAI_ERROR_NETWORK_INVALID_API_ARGUMENTS, net_ctx->_return_code)
  /* get the number of internals states (supporting multi-heap also for internal states) */
  *n_states = STAI_NETWORK_STATES_NUM;

  STAI_UNUSED(states)
return net_ctx->_return_code;
}


/*****************************************************************************/
/*  Setters APIs Section  */

STAI_API_ENTRY
stai_return_code stai_network_set_activations(
  stai_network* network,
  const stai_ptr* activations,
  const stai_size n_activations)
{
  _STAI_CONTEXT_ACQUIRE(net_ctx, network)
const uintptr_t _activations_alignment[] = STAI_NETWORK_ACTIVATIONS_ALIGNMENTS;
  STAI_PRINT("  [stai_network_set_activations] network(%p) activations[%d]: %p\n\n", net_ctx, n_activations, activations)
  _STAI_SET_ERROR(net_ctx, !activations,
                  STAI_ERROR_NETWORK_INVALID_API_ARGUMENTS, net_ctx->_return_code)
  _STAI_SET_ERROR(net_ctx, n_activations!=STAI_NETWORK_ACTIVATIONS_NUM,
                  STAI_ERROR_NETWORK_INVALID_ACTIVATIONS_NUM, net_ctx->_return_code)

  for (stai_size idx=0; activations && idx<STAI_NETWORK_ACTIVATIONS_NUM; idx++) {
    STAI_PRINT("  activation[%d]: %p\n", idx, activations[idx])
    _STAI_SET_ERROR(net_ctx, activations[idx]==NULL,
                    STAI_ERROR_NETWORK_INVALID_ACTIVATIONS_PTR, net_ctx->_return_code)
    _STAI_SET_ERROR(net_ctx, ((uintptr_t)activations[idx]) & (_activations_alignment[idx]-1),
                    STAI_ERROR_INVALID_BUFFER_ALIGNMENT, net_ctx->_return_code)
    net_ctx->_activations[idx] = activations[idx];
  }
  net_ctx->_inputs[0] = activations[0] + 188;

  net_ctx->_outputs[0] = activations[0] + 16;
_stai_network_check(net_ctx);
  return net_ctx->_return_code;
}


STAI_API_ENTRY
stai_return_code stai_network_set_weights(
  stai_network* network,
  const stai_ptr* weights,
  const stai_size n_weights)
{
  _STAI_CONTEXT_ACQUIRE(net_ctx, network)
const uintptr_t _weights_alignment[] = STAI_NETWORK_WEIGHTS_ALIGNMENTS;
  _STAI_SET_ERROR(net_ctx, !weights,
                  STAI_ERROR_NETWORK_INVALID_API_ARGUMENTS, net_ctx->_return_code)
  _STAI_SET_ERROR(net_ctx, n_weights!=STAI_NETWORK_WEIGHTS_NUM,
                  STAI_ERROR_NETWORK_INVALID_WEIGHTS_NUM, net_ctx->_return_code)
  for (stai_size idx=0; weights && idx<STAI_NETWORK_WEIGHTS_NUM; idx++) {
    STAI_PRINT("  weight[%d]: %p\n", idx, weights[idx])
    _STAI_SET_ERROR(net_ctx, weights[idx]==NULL,
                    STAI_ERROR_NETWORK_INVALID_WEIGHTS_PTR, net_ctx->_return_code)
    _STAI_SET_ERROR(net_ctx, ((uintptr_t)weights[idx]) & (_weights_alignment[idx]-1),
                    STAI_ERROR_INVALID_BUFFER_ALIGNMENT, net_ctx->_return_code)
    net_ctx->_weights[idx] = weights[idx];
  }_stai_network_check(net_ctx);
  return net_ctx->_return_code;
}


STAI_API_ENTRY
stai_return_code stai_network_set_inputs(
  stai_network* network,
  const stai_ptr* inputs,
  const stai_size n_inputs)
{
  const uintptr_t _inputs_alignment[] = STAI_NETWORK_IN_ALIGNMENTS;
  _STAI_CONTEXT_ACQUIRE(net_ctx, network)
  _STAI_SET_ERROR(net_ctx, !inputs,
                  STAI_ERROR_NETWORK_INVALID_API_ARGUMENTS, net_ctx->_return_code)
  _STAI_SET_ERROR(net_ctx, n_inputs!=STAI_NETWORK_IN_NUM,
                  STAI_ERROR_NETWORK_INVALID_IN_NUM, net_ctx->_return_code)

  for (stai_size idx=0; inputs && idx<STAI_NETWORK_IN_NUM; idx++) {
    STAI_PRINT("  input[%d]: %p\n", idx, inputs[idx])
    _STAI_SET_ERROR(net_ctx, inputs[idx]==NULL,
                    STAI_ERROR_NETWORK_INVALID_IN_PTR, net_ctx->_return_code)
    _STAI_SET_ERROR(net_ctx, ((uintptr_t)inputs[idx]) & (_inputs_alignment[idx]-1),
                    STAI_ERROR_INVALID_BUFFER_ALIGNMENT, net_ctx->_return_code)
    net_ctx->_inputs[idx] = inputs[idx];
  }

  _stai_network_check(net_ctx);
  return net_ctx->_return_code;
}


STAI_API_ENTRY
stai_return_code stai_network_set_outputs(
  stai_network* network,
  const stai_ptr* outputs,
  const stai_size n_outputs)
{
  const uintptr_t _outputs_alignment[] = STAI_NETWORK_OUT_ALIGNMENTS;
  _STAI_CONTEXT_ACQUIRE(net_ctx, network)
  _STAI_SET_ERROR(net_ctx, !outputs,
                  STAI_ERROR_NETWORK_INVALID_API_ARGUMENTS, net_ctx->_return_code)
  _STAI_SET_ERROR(net_ctx, n_outputs!=STAI_NETWORK_OUT_NUM,
                  STAI_ERROR_NETWORK_INVALID_OUT_NUM, net_ctx->_return_code)

  for (stai_size idx=0; outputs && idx<n_outputs; idx++) {
    STAI_PRINT("  output[%d]: %p\n", idx, outputs[idx])
    _STAI_SET_ERROR(net_ctx, outputs[idx]==NULL,
                    STAI_ERROR_NETWORK_INVALID_OUT_PTR, net_ctx->_return_code)
    _STAI_SET_ERROR(net_ctx, ((uintptr_t)outputs[idx]) & (_outputs_alignment[idx]-1),
                    STAI_ERROR_INVALID_BUFFER_ALIGNMENT, net_ctx->_return_code)
    net_ctx->_outputs[idx] = outputs[idx];
  }

  _stai_network_check(net_ctx);
  return net_ctx->_return_code;
}


STAI_API_ENTRY
stai_return_code stai_network_set_states(
  stai_network* network,
  const stai_ptr* states,
  const stai_size n_states)
{
  _STAI_CONTEXT_ACQUIRE(net_ctx, network)

  STAI_UNUSED(states)
  STAI_UNUSED(n_states)
_stai_network_check(net_ctx);
  return net_ctx->_return_code;
}

STAI_API_ENTRY
stai_return_code stai_network_set_callback(
  stai_network* network, const stai_event_cb cb, void* cb_cookie)
{
  _STAI_CONTEXT_ACQUIRE(net_ctx, network)
  STAI_PRINT("  set_callback %p cb %p cookie %p\n", net_ctx, cb, cb_cookie)
  // _STAI_SET_ERROR(net_ctx, cb==NULL, STAI_ERROR_NETWORK_INVALID_CALLBACK, net_ctx->_return_code)
  net_ctx->_callback = cb;
  net_ctx->_callback_cookie = cb_cookie;
  return net_ctx->_return_code;
}

#undef _STAI_SET_ERROR
#undef _STAI_CONTEXT_ALIGNMENT
#undef _STAI_CONTEXT_ACQUIRE
#undef _STAI_NETWORK_EVENT_NODE_START_CB
#undef _STAI_NETWORK_EVENT_NODE_STOP_CB
#undef _STAI_NETWORK_MODEL_SIGNATURE
#undef _STAI_NETWORK_DATETIME
#undef _STAI_NETWORK_COMPILE_DATETIME
