Yubin-dev0/thesis-edgeai-adaptive-kalman-embedded/firmware/Core/Inc/network_details.h

/**
  ******************************************************************************
  * @file    network.h
  * @date    2026-05-20T19:15:52+0900
  * @brief   ST.AI Tool Automatic Code Generator for Embedded NN computing
  ******************************************************************************
  * @attention
  *
  * Copyright (c) 2026 STMicroelectronics.
  * All rights reserved.
  *
  * This software is licensed under terms that can be found in the LICENSE file
  * in the root directory of this software component.
  * If no LICENSE file comes with this software, it is provided AS-IS.
  ******************************************************************************
  */
#ifndef STAI_NETWORK_DETAILS_H
#define STAI_NETWORK_DETAILS_H

#include "stai.h"
#include "layers.h"

const stai_network_details g_network_details = {
  .tensors = (const stai_tensor[4]) {
   { .size_bytes = 6, .flags = (STAI_FLAG_HAS_BATCH|STAI_FLAG_CHANNEL_LAST), .format = STAI_FORMAT_S8, .shape = {2, (const int32_t[2]){1, 6}}, .scale = {1, (const float[1]){0.9137470722198486}}, .zeropoint = {1, (const int16_t[1]){31}}, .name = "serving_default_features0_output" },
   { .size_bytes = 16, .flags = (STAI_FLAG_HAS_BATCH|STAI_FLAG_CHANNEL_LAST), .format = STAI_FORMAT_S8, .shape = {2, (const int32_t[2]){1, 16}}, .scale = {1, (const float[1]){0.13485567271709442}}, .zeropoint = {1, (const int16_t[1]){-128}}, .name = "gemm_0_output" },
   { .size_bytes = 8, .flags = (STAI_FLAG_HAS_BATCH|STAI_FLAG_CHANNEL_LAST), .format = STAI_FORMAT_S8, .shape = {2, (const int32_t[2]){1, 8}}, .scale = {1, (const float[1]){0.1094886064529419}}, .zeropoint = {1, (const int16_t[1]){-128}}, .name = "gemm_1_output" },
   { .size_bytes = 1, .flags = (STAI_FLAG_HAS_BATCH|STAI_FLAG_CHANNEL_LAST), .format = STAI_FORMAT_S8, .shape = {2, (const int32_t[2]){1, 1}}, .scale = {1, (const float[1]){0.03876088559627533}}, .zeropoint = {1, (const int16_t[1]){-128}}, .name = "gemm_2_output" }
  },
  .nodes = (const stai_node_details[3]){
    {.id = 0, .type = AI_LAYER_DENSE_TYPE, .input_tensors = {1, (const int32_t[1]){0}}, .output_tensors = {1, (const int32_t[1]){1}} }, /* gemm_0 */
    {.id = 1, .type = AI_LAYER_DENSE_TYPE, .input_tensors = {1, (const int32_t[1]){1}}, .output_tensors = {1, (const int32_t[1]){2}} }, /* gemm_1 */
    {.id = 2, .type = AI_LAYER_DENSE_TYPE, .input_tensors = {1, (const int32_t[1]){2}}, .output_tensors = {1, (const int32_t[1]){3}} } /* gemm_2 */
  },
  .n_nodes = 3
};
#endif
