Yubin-dev0/thesis-edgeai-adaptive-kalman-embedded/(commit log)

2026-04-03 feat: init project structure + CubeIDE pin assignment
2026-04-06 feat: 200Hz control loop skeleton with DMA CSV logging
2026-04-06 Phase 2: Encoder verification complete (TIM2/TIM4 x4 quadrature)
2026-04-07 Phase 3: HC-SR04 verification - TIM3 IC interrupt-driven, HSE BYPASS 180MHz, 297mm pass (-5.7mm), non-blocking main loop verified
2026-04-29 test(phase0): power supply verification - LiPo 7.4V, Buck 5.0-5.1V, decoupling installed
2026-05-03 test(phase4a): TB6612FNG motor standalone verification - 30% PWM forward rotation confirmed
2026-05-14 chore: add VL53L0X driver files (Phase 1)
2026-05-14 chore: remove duplicate phase 0 wiring image
2026-05-15 feat: add Phase 4-B motor+sensor noise measurement firmware
    [main.c]
2026-05-17 test: add Phase 6 sensor+KF integration verification report
    [phase6_step6_csv.csv]
2026-05-17 feat: Phase 6 firmware - 200Hz loop, Fixed KF, 18-field CSV, IWDG
    [firmware.ioc, main.c]
2026-05-19 test: add Phase 7 manual integration verification
    [7b_acrylic.csv, 7b_black.csv, 7b_gray.csv, 7b_white.csv, 7e_run02.csv, 7f_run89_interim.csv, 7f_run90_full.csv, 7f_run91_clean.csv]
2026-05-19 fix: align KF predict/update 1:1 to ToF DataReady (Scheme C), complete E1 baseline
    [E1_run01.csv, E1_run02.csv, E1_run03.csv, E1_run04.csv, E1_run05.csv, R0_calibration_run.csv]
2026-05-20 test: add E2 reflectivity measurement data (9 runs)
    [E2_acryl_run01.csv, E2_acryl_run02.csv, E2_acryl_run03.csv, E2_black_run01.csv, E2_black_run02.csv, E2_black_run03.csv, E2_white_run01.csv, E2_white_run02.csv]
2026-05-20 data: add E3 run01-05 measurements (dynamic occlusion)
    [E1_run01_f5fixed.csv, E1_run02_f5fixed.csv, E1_run03_f5fixed.csv, E1_run04_f5fixed.csv, E1_run05_f5fixed.csv, E3_run01.csv, E3_run02.csv, E3_run03.csv]
2026-05-20 feat: complete TinyML-AKF integration (ai_init fix + INT8 + expm1 + 28-col CSV)
    [test_predictions.csv]
2026-05-20 feat: add E2 final measurement data (28col, 9 runs)
    [E2_acryl_run01.csv, E2_acryl_run02.csv, E2_acryl_run03.csv, E2_black_run01.csv, E2_black_run02.csv, E2_black_run03.csv, E2_white_run01.csv, E2_white_run02.csv]
2026-05-20 feat: add E3 final measurement data (28col, 5 runs)
    [E3_run01.csv, E3_run02.csv, E3_run03.csv, E3_run04.csv, E3_run05.csv]
2026-05-20 feat: E4 30-min static stability firmware(CSV_SCENARIO_ID = 4, 360k loops)
    [main.c]
2026-05-20 feat: add E4 30-min static stability raw logs
    [E4_run01.csv, E4_run02.csv, E4_run03.csv]
2026-05-21 test: add E5 unknown surface generalization (5 runs, gray foam 5T)
    [E5_run01.csv, E5_run02.csv, E5_run03.csv, E5_run04.csv, E5_run05.csv]
2026-09-09 chore(experiments): add E1 baseline final measurement logs (run01-05)
    [E1_run01.csv, E1_run02.csv, E1_run03.csv, E1_run04.csv, E1_run05.csv]
2026-09-22 docs: correct encoder sign root cause and fix left/right motor mapping
    Encoder sign inversion comes from mirror-symmetric motor mounting, not from the Phase 4B lead swap (which was on the left motor and does not affect encoder polarity). Add A=right/TIM4, B=left/TIM2 mapping to Phase 2/4A/4B.
    Phase 7: note that run90/run91 used main power while the final as-built HC-06 supply is buck #2, and that only the left-motor 100 nF cap remains. Verified on the robot 2026-09-22.
2026-09-22 docs(phase5): state final HC-06 supply as separate LM2596 buck #2
    The Phase 7 trial became the as-built configuration (4xAA 6 V pack -> buck #2, single GND jumper); buck #2 Vout not measured. Verified 2026-09-22.
2026-09-22 docs(phase1,3): annotate decoupling caps and VL53L0X supply as-built
    The 100 nF caps at VL53L0X and HC-SR04 are not on the final build; the +5 V rail carries one 100 uF electrolytic. VL53L0X VIN is on +5 V (on-board regulator), I2C pull-ups on 3V3. Bench records kept as history. Verified 2026-09-22.
2026-09-22 docs(E4): retract battery ADC monitoring claim
    PA4 is not wired and the firmware has no ADC sampling code (ADC1 is only initialised); no battery voltage record exists for the E4 runs.
2026-09-22 docs(readme): replace ADC power-monitor row with as-built power path
    Describe buck #1 -> CN7-18, the 5 V rail for VL53L0X/HC-SR04, and buck #2 for HC-06; mark ADC1 IN4 as initialised but unwired/unsampled; add L/R motor mapping.
2026-09-26 docs: correct encoder-sign root cause in code comments, restore E4_run02 header, note PWM config mismatch
    main.c: header note and inline comment now state the verified cause (mirror-mounted right motor), not motor wiring.
    analyze_7e.py: docstring updated to the same cause.
    E4_run02.csv: col0..col27 placeholder header replaced with the real 28-column header (identical to run01/run03).
    04A TEST_RESULT: record that 10 kHz PWM was test-firmware only; the integrated firmware runs TIM1 PSC0/ARR65535 (~2.75 kHz), never unified.
    [E4_run02.csv]
